sercona/Toaster-Oven-Solder-Reflow-with-ESP32-and-CANbus/photos/cheap_toaster_oven.jpg

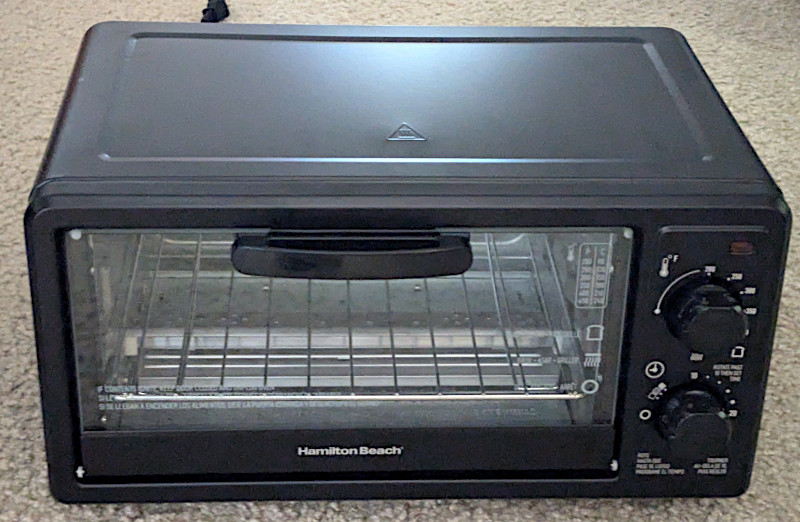
photos/cheap_toaster_oven.jpg
