sercona/Toaster-Oven-Solder-Reflow-with-ESP32-and-CANbus/photos/set_soak_temp.jpg

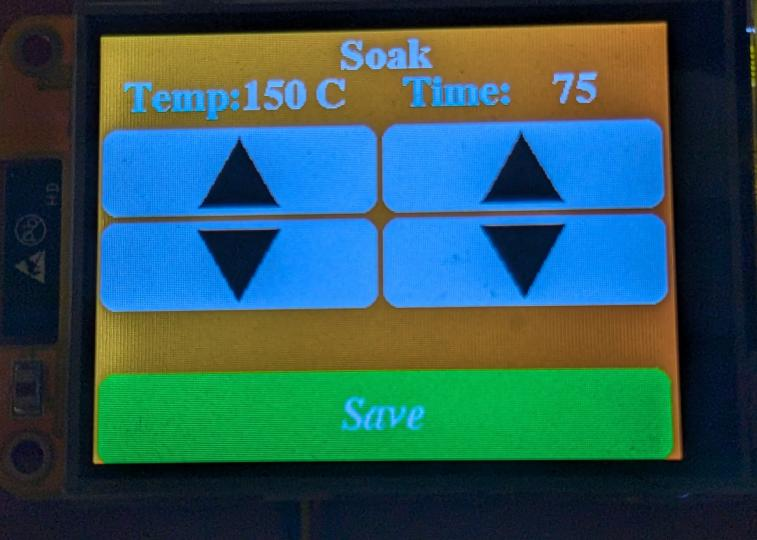
photos/set_soak_temp.jpg
