sercona/Toaster-Oven-Solder-Reflow-with-ESP32-and-CANbus/(commit log)

2025-10-12 sample photos and screen caps
2025-10-12 Add files via upload
    compare of the paper printed profile and what you can get close to, using this application
